ProtocolElectronics/Portable-Linear-Power-Supply/BOM.md

### Bill of Materials

| part | part # (digikey.com) | quanity |
| --- | --- | --- |
|LT3080|LT3080ET#PBF-ND|1|
|Optical Encoder|987-1195-ND|1|
|resistor 10k|RNF14FTD10K0CT-ND|20|
|resistor 2R|RHM2DCT-ND|10|
|resistor 330R|CF14JT330RCT-ND|1|
|resistor 1k|CF14JT1K00CT-ND|1|
|resistor 100R|PPC100ZCT-ND|2|
|1N5400|1N5400GOS-ND |1|
|2N3904BU|2N3904FS-ND|1|
|MAX4080|MAX4080FASA+-ND|1|
|capacitor 0.1uF|BC2665CT-ND|8|
|capacitor 10uF|493-5915-1-ND|3|
|capacitor 1uF|BC1168CT-ND|1|
|LM334Z-NOPB|LM334ZNS/NOPB-ND|1|
|barrel power connector|732-5931-ND|1|
|SPDT switch|EG1903-ND|3|
|7805TV|497-1443-5-ND|1|
|TLC2272|296-1812-5-ND|1|
|Heat Sink|HS403-ND|1|
|Atmega 328|ATMEGA328-PU-ND|1|
|7 Segment Display|754-1660-5-ND|1|
|9v battery holder|BC9VPC-ND|2|
