ProtocolElectronics/Portable-Linear-Power-Supply/eagle files/BRD.brd

## EAGLE design eagle files/BRD.brd (2017-07-22)

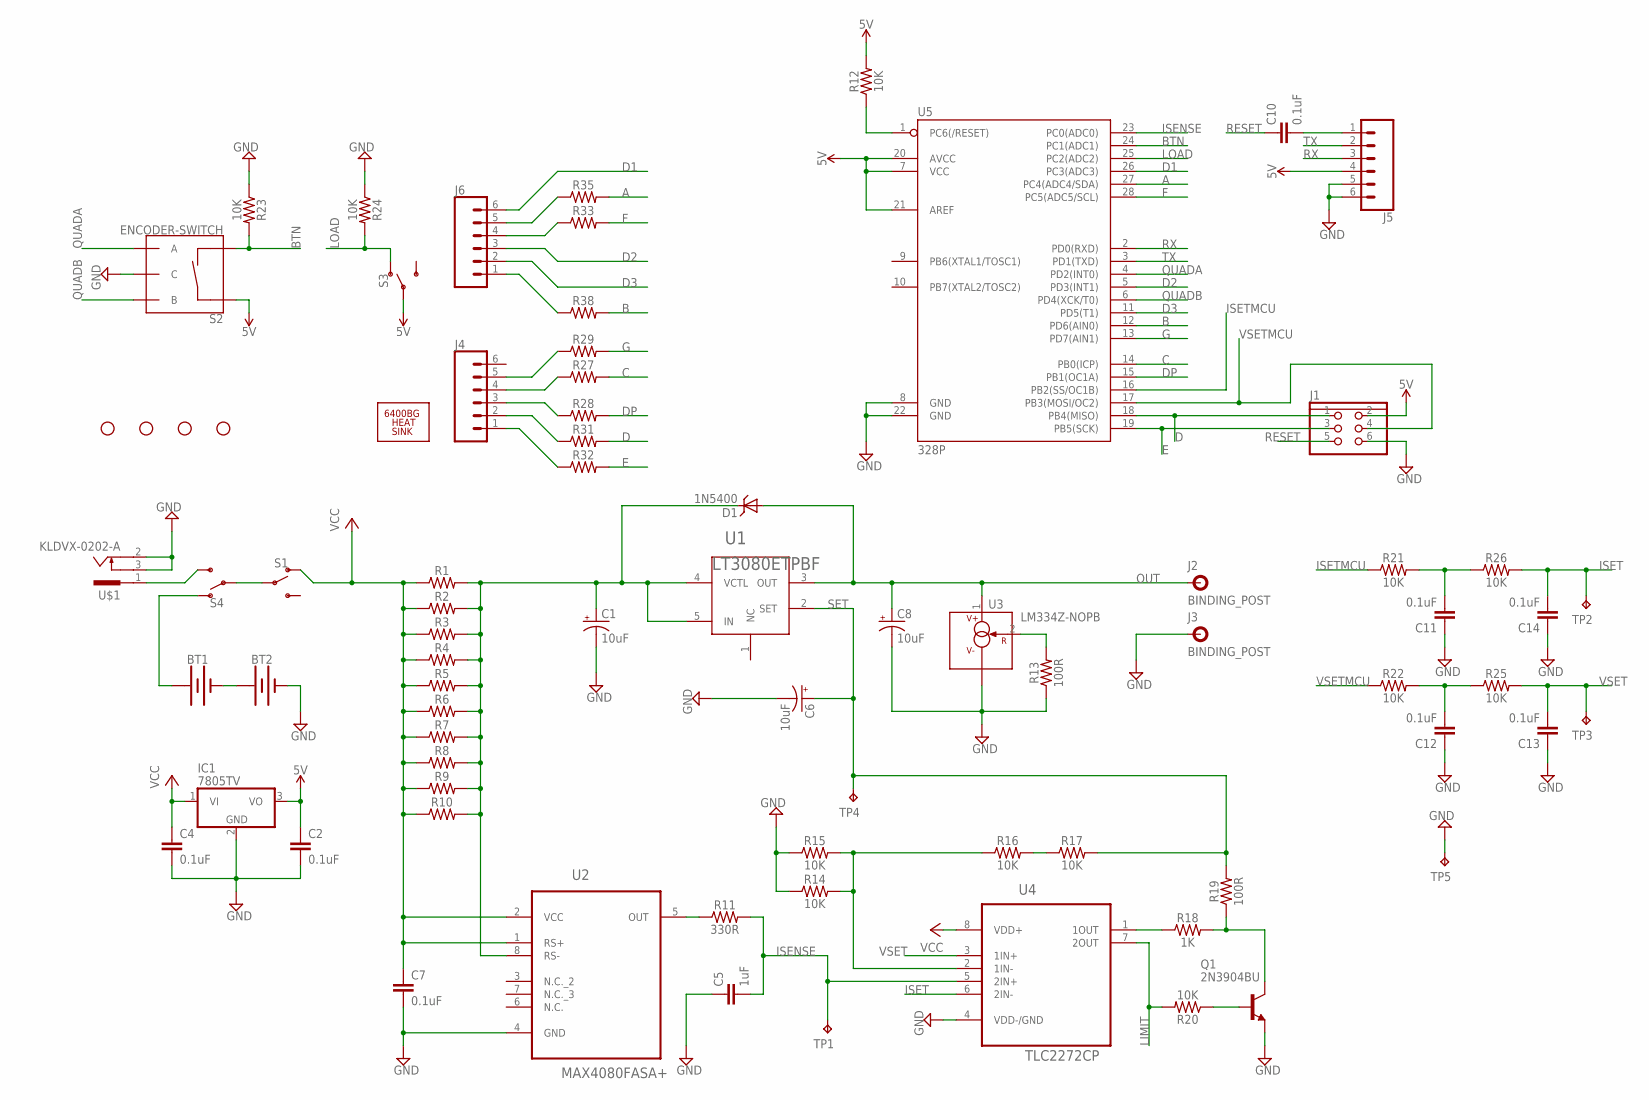
[picture p1: schematic SCH.sch]

Parts:
BT1, BT2: BATTERY-9V; BATTCON_9V
C1, C6, C8: 10uF; CPOL-RADIAL-2.5MM-5MM
C2, C4, C7, C10, C11, C12, C13, C14: 0.1uF; CAP-PTH-2.54
C5: 1uF; CAP-PTH-2.54
D1: 1N5400; DO201-15
H1, H2, H3, H4: STAND-OFF
H5: 6400BG_HEATSINK
IC1: 7805TV; TO220V
J1: PINHD2X03
J2, J3: BINDING_POST
J4, J5, J6: CONN_06NO_SILK_FEMALE_PTH; 1X06_NO_SILK
Q1: 2N3904BU; TO92
R1, R2, R3, R4, R5, R6, R7, R8, R9, R10: 2R; 0603
R11: 330R; AXIAL-0.3
R12, R14, R15, R16, R17, R20, R21, R22, R23, R24, R25, R26, R27, R28, R29, R31, R32, R33, R35, R38: 10K; AXIAL-0.3
R13, R19: 100R; AXIAL-0.3
R18: 1K; AXIAL-0.3
S1, S3, S4: SWITCH-SPDT-PTH-11.6X4.0MM-LOCK; SWITCH_SPDT_PTH_11.6X4.0MM_LOCK
S2: ENCODER-SWITCH; ROTARY_ENC_PLAIN
TP1, TP2, TP3, TP4, TP5: TPTP14SQ; TP14SQ
U1: LT3080ETPBF; TO220-51
U2: MAX4080FASA+; SOIC127P600X175-8N
U3: LM334Z-NOPB; TO92
U4: TLC2272CP; DIP254P762X508-8
U5: 328P; DIP28
U$1: KLDVX-0202-A

Connections:
5V: C2.1, IC1.3 (VO), J1.2, J5.4, R12.P$2 (2), S2.SW+, S3.2, U5.7 (VCC), U5.20 (AVCC), U5.21 (AREF)
A: R35.P$2 (2), U5.27 (PC4(ADC4/SDA))
B: R38.P$2 (2), U5.12 (PD6(AIN0))
BTN: R23.P$2 (2), S2.SW-, U5.24 (PC1(ADC1))
C: R27.P$2 (2), U5.14 (PB0(ICP))
D: J1.1, R31.P$2 (2), U5.18 (PB4(MISO))
D1: J6.6, U5.26 (PC3(ADC3))
D2: J6.3, U5.5 (PD3(INT1))
D3: J6.2, U5.11 (PD5(T1))
DP: R28.P$2 (2), U5.15 (PB1(OC1A))
E: J1.3, R32.P$2 (2), U5.19 (PB5(SCK))
F: R33.P$2 (2), U5.28 (PC5(ADC5/SCL))
G: R29.P$2 (2), U5.13 (PD7(AIN1))
GND: BT2.-, C1.2 (-), C2.2, C4.2, C5.1, C6.2 (-), C7.2, C8.2 (-), C11.1, C12.1, C13.1, C14.1, IC1.2 (GND), J1.6, J3.P$1, J5.5, J5.6, Q1.3 (E), R13.P$1 (1), R14.P$1 (1), R15.P$1 (1), R23.P$1 (1), R24.P$1 (1), S2.C, TP5.TP, U2.4 (GND), U3.3 (V-), U4.4 (VDD-/GND), U5.8 (GND), U5.22 (GND), U$1.2, U$1.3
ISENSE: C5.2, R11.P$2 (2), TP1.TP, U4.5 (2IN+), U5.23 (PC0(ADC0))
ISET: C14.2, R26.P$2 (2), TP2.TP, U4.6 (2IN-)
ISETMCU: R21.P$1 (1), U5.16 (PB2(SS/OC1B))
LIMIT: R20.P$2 (2), U4.7 (2OUT)
LOAD: R24.P$2 (2), S3.1 (O), U5.25 (PC2(ADC2))
unnamed: S4.3 (S), U$1.1
unnamed: C10.2, J5.1
unnamed: C1.1 (+), D1.C, R1.2, R2.2, R3.2, R4.2, R5.2, R6.2, R7.2, R8.2, R9.2, R10.2, U1.4 (VCTL), U1.5 (IN), U2.8 (RS-)
unnamed: R11.P$1 (1), U2.5 (OUT)
unnamed: R18.P$1 (1), U4.1 (1OUT)
unnamed: R13.P$2 (2), U3.2 (R)
unnamed: Q1.1 (C), R18.P$2 (2), R19.P$1 (1)
unnamed: Q1.2 (B), R20.P$1 (1)
unnamed: R16.P$2 (2), R17.P$1 (1)
unnamed: R14.P$2 (2), R15.P$2 (2), R16.P$1 (1), U4.2 (1IN-)
unnamed: BT1.-, BT2.+
unnamed: S1.2, S4.2
unnamed: BT1.+, S4.1 (O)
unnamed: J4.5, R29.P$1 (1)
unnamed: J4.4, R27.P$1 (1)
unnamed: J4.3, R28.P$1 (1)
unnamed: C11.2, R21.P$2 (2), R26.P$1 (1)
unnamed: C12.2, R22.P$2 (2), R25.P$1 (1)
unnamed: J4.2, R31.P$1 (1)
unnamed: J4.1, R32.P$1 (1)
unnamed: J6.5, R35.P$1 (1)
unnamed: J6.4, R33.P$1 (1)
unnamed: J6.1, R38.P$1 (1)
OUT: C8.1 (+), D1.A, J2.P$1, U1.3 (OUT), U3.1 (V+)
QUADA: S2.A, U5.4 (PD2(INT0))
QUADB: S2.B, U5.6 (PD4(XCK/T0))
RESET: C10.1, J1.5, R12.P$1 (1), U5.1 (PC6(/RESET))
RX: J5.3, U5.2 (PD0(RXD))
SET: C6.1 (+), R17.P$2 (2), R19.P$2 (2), TP4.TP, U1.2 (SET)
TX: J5.2, U5.3 (PD1(TXD))
VCC: C4.1, C7.1, IC1.1 (VI), R1.1, R2.1, R3.1, R4.1, R5.1, R6.1, R7.1, R8.1, R9.1, R10.1, S1.1 (O), U2.1 (RS+), U2.2 (VCC), U4.8 (VDD+)
VSET: C13.2, R25.P$2 (2), TP3.TP, U4.3 (1IN+)
VSETMCU: J1.4, R22.P$1 (1), U5.17 (PB3(MOSI/OC2))

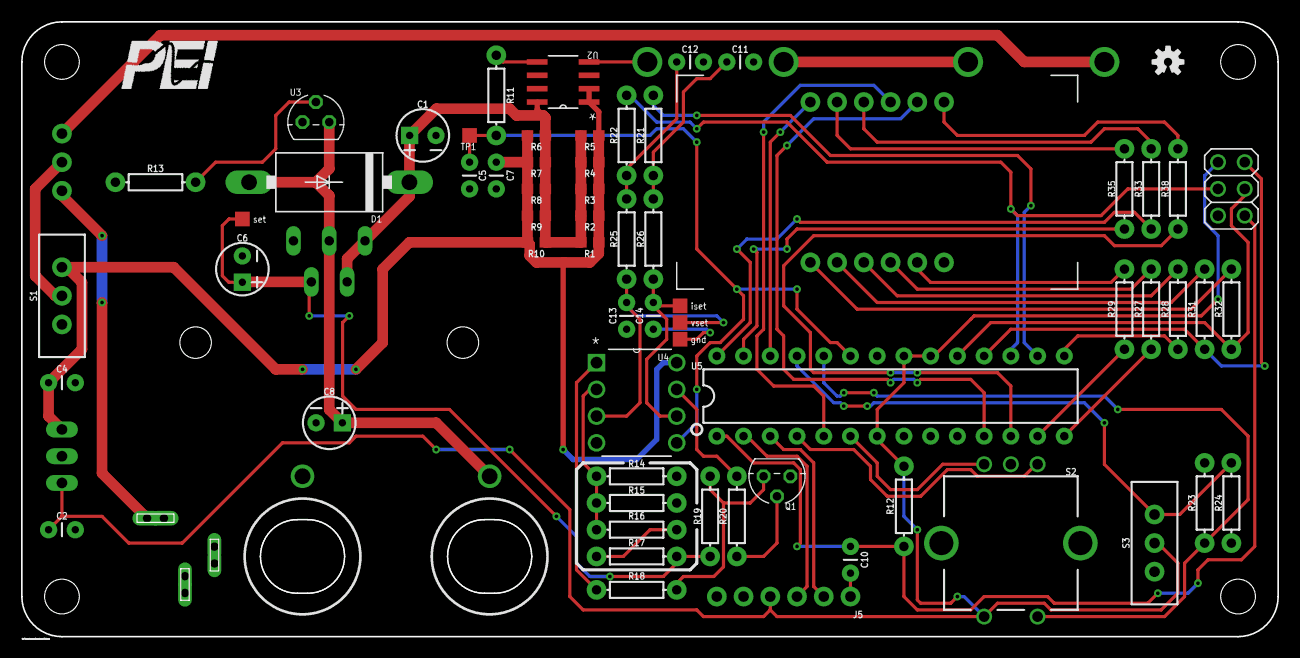
[picture p2: board BRD.brd from above]

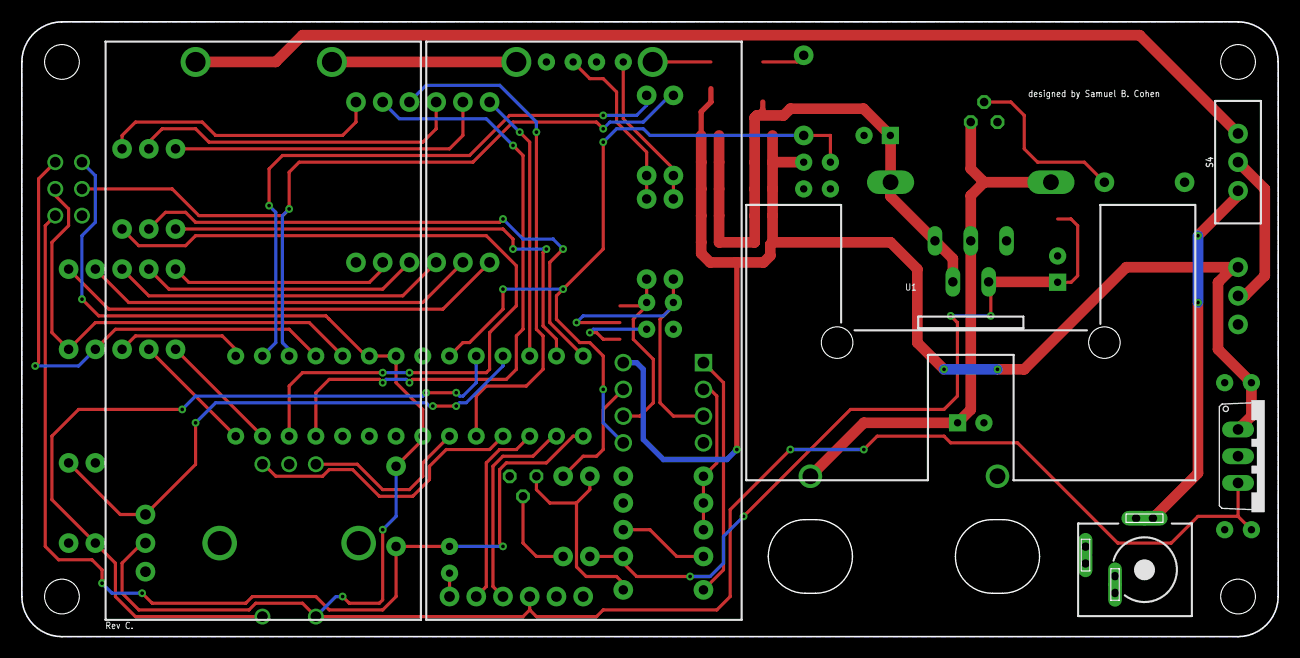
[picture p3: board BRD.brd from below]

Board: 2 copper layers, 119.4 x 58.4 mm, 78 parts (7 on the bottom side), 52 nets.

Other parts of the board:
U$2: OSHW-LOGO-S
