ProtocolElectronics/Portable-Linear-Power-Supply/(commit log)

2017-07-22 add eagle files
    [LinearPSURevDV4.brd, LinearPSURevDV4.sch]
2017-07-25 add assembly instructions
2017-07-25 add operation instructions
    [BRD.brd, SCH.sch]
2017-07-28 add BOM and License information
